julioflima/Blackout-Control/schematics/receiver-sch.pdf

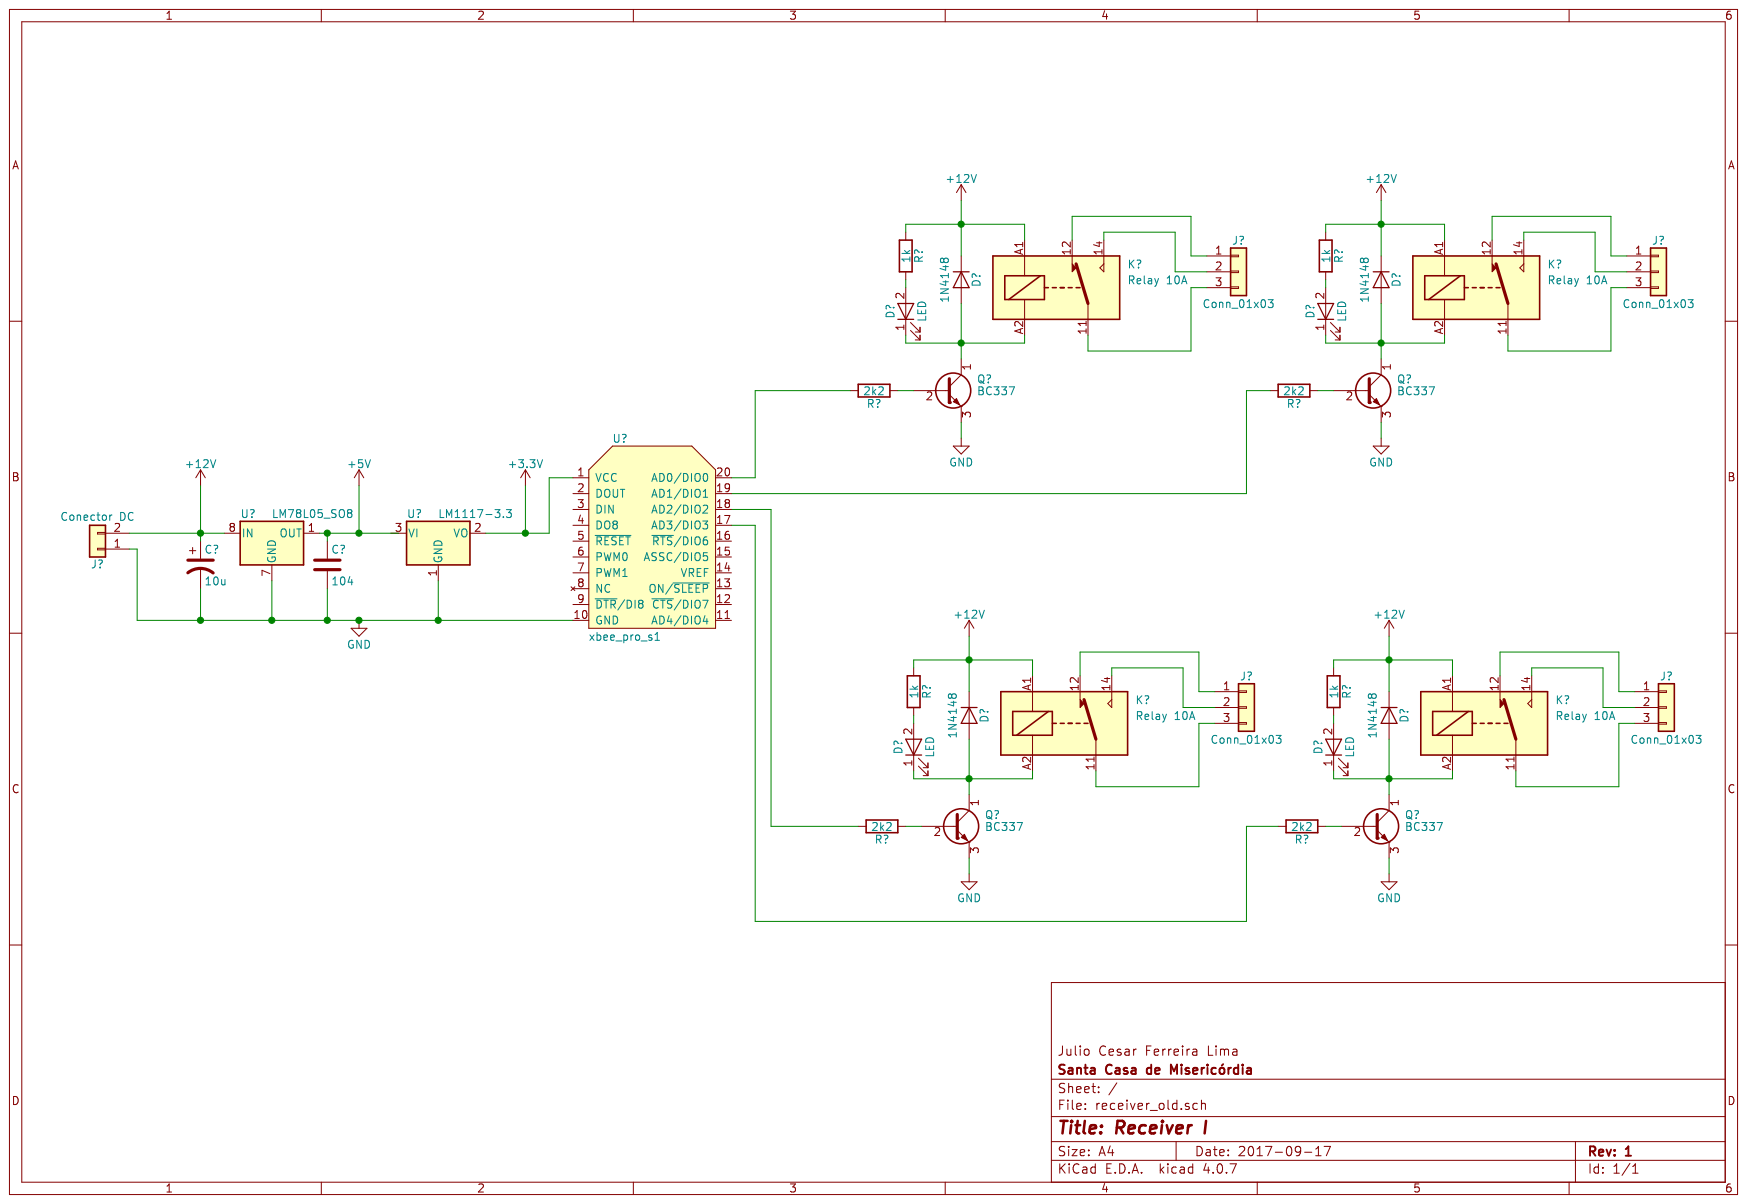
[picture p9: page 1]
