julioflima/Blackout-Control/schematics/transmitter-board.pdf

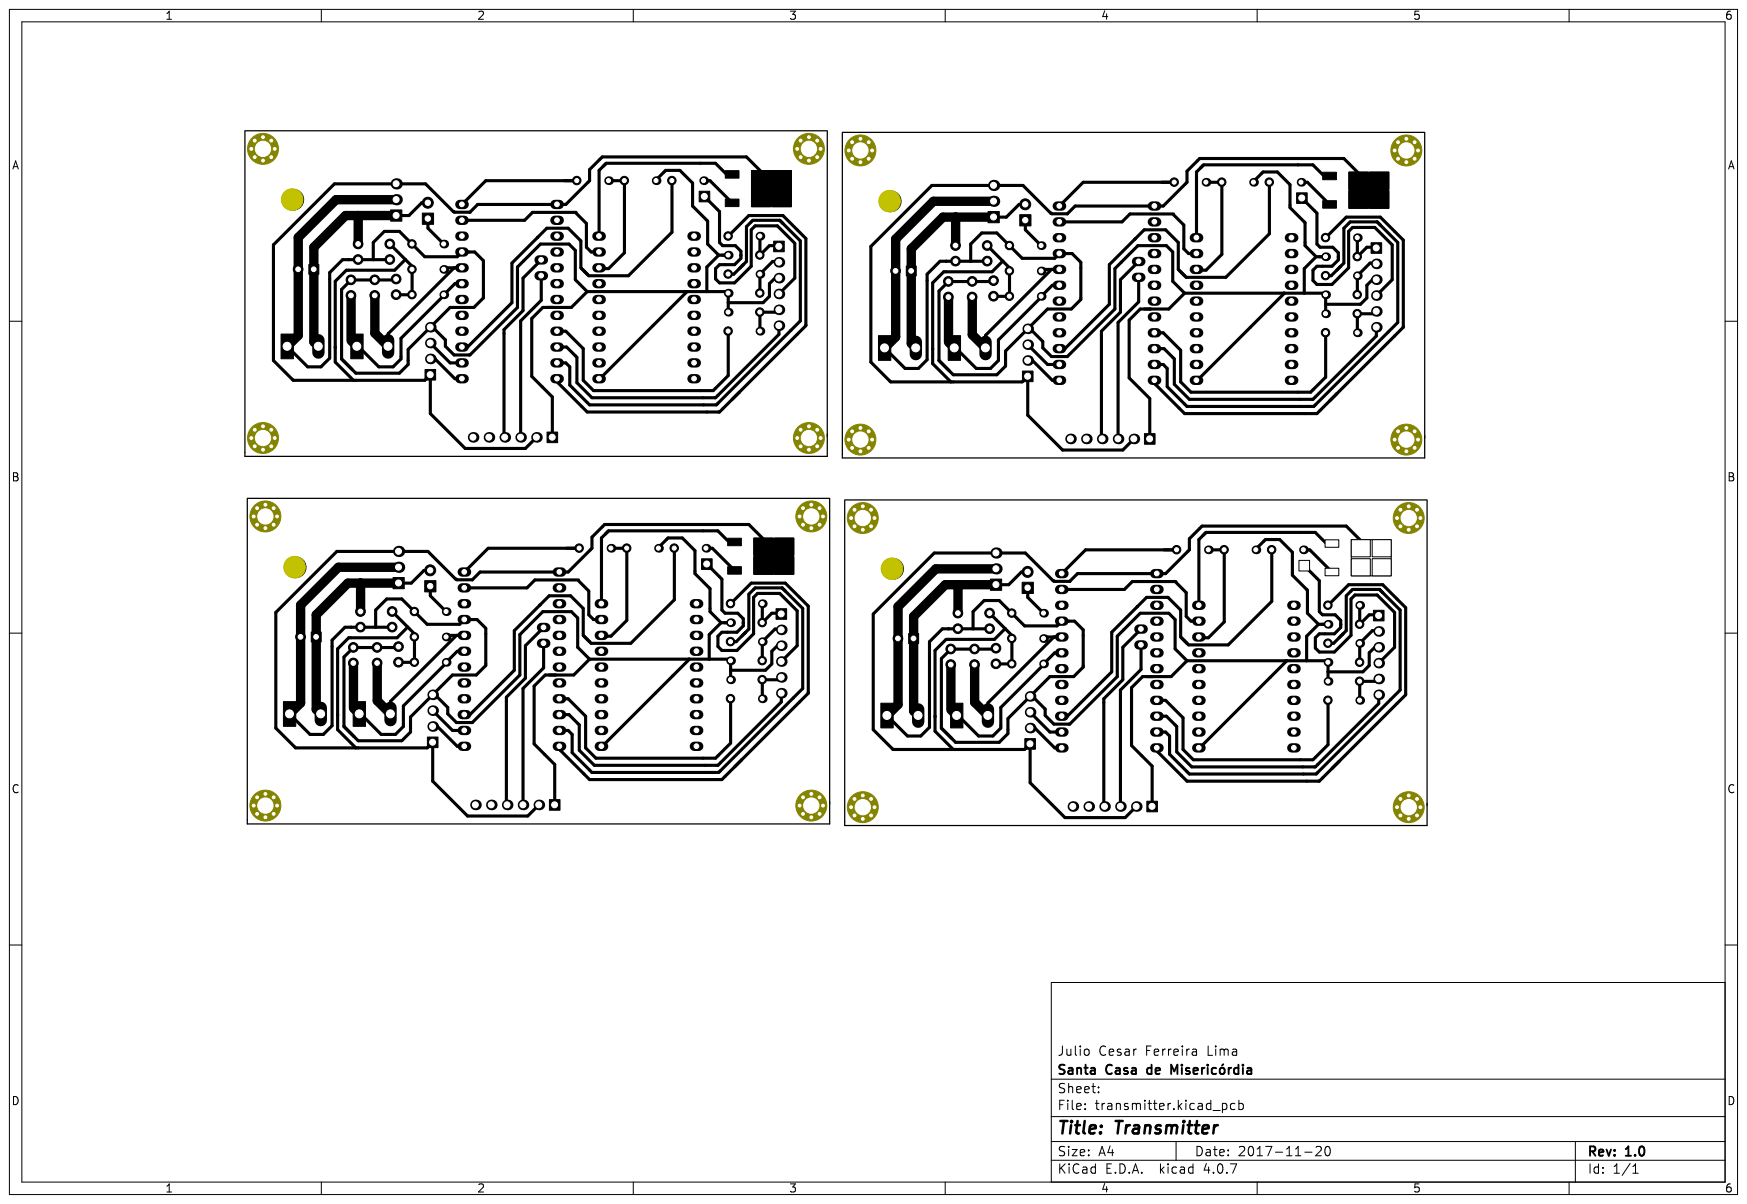
[picture p10: page 1]
