julioflima/Blackout-Control/schematics/transmitter-sch.pdf

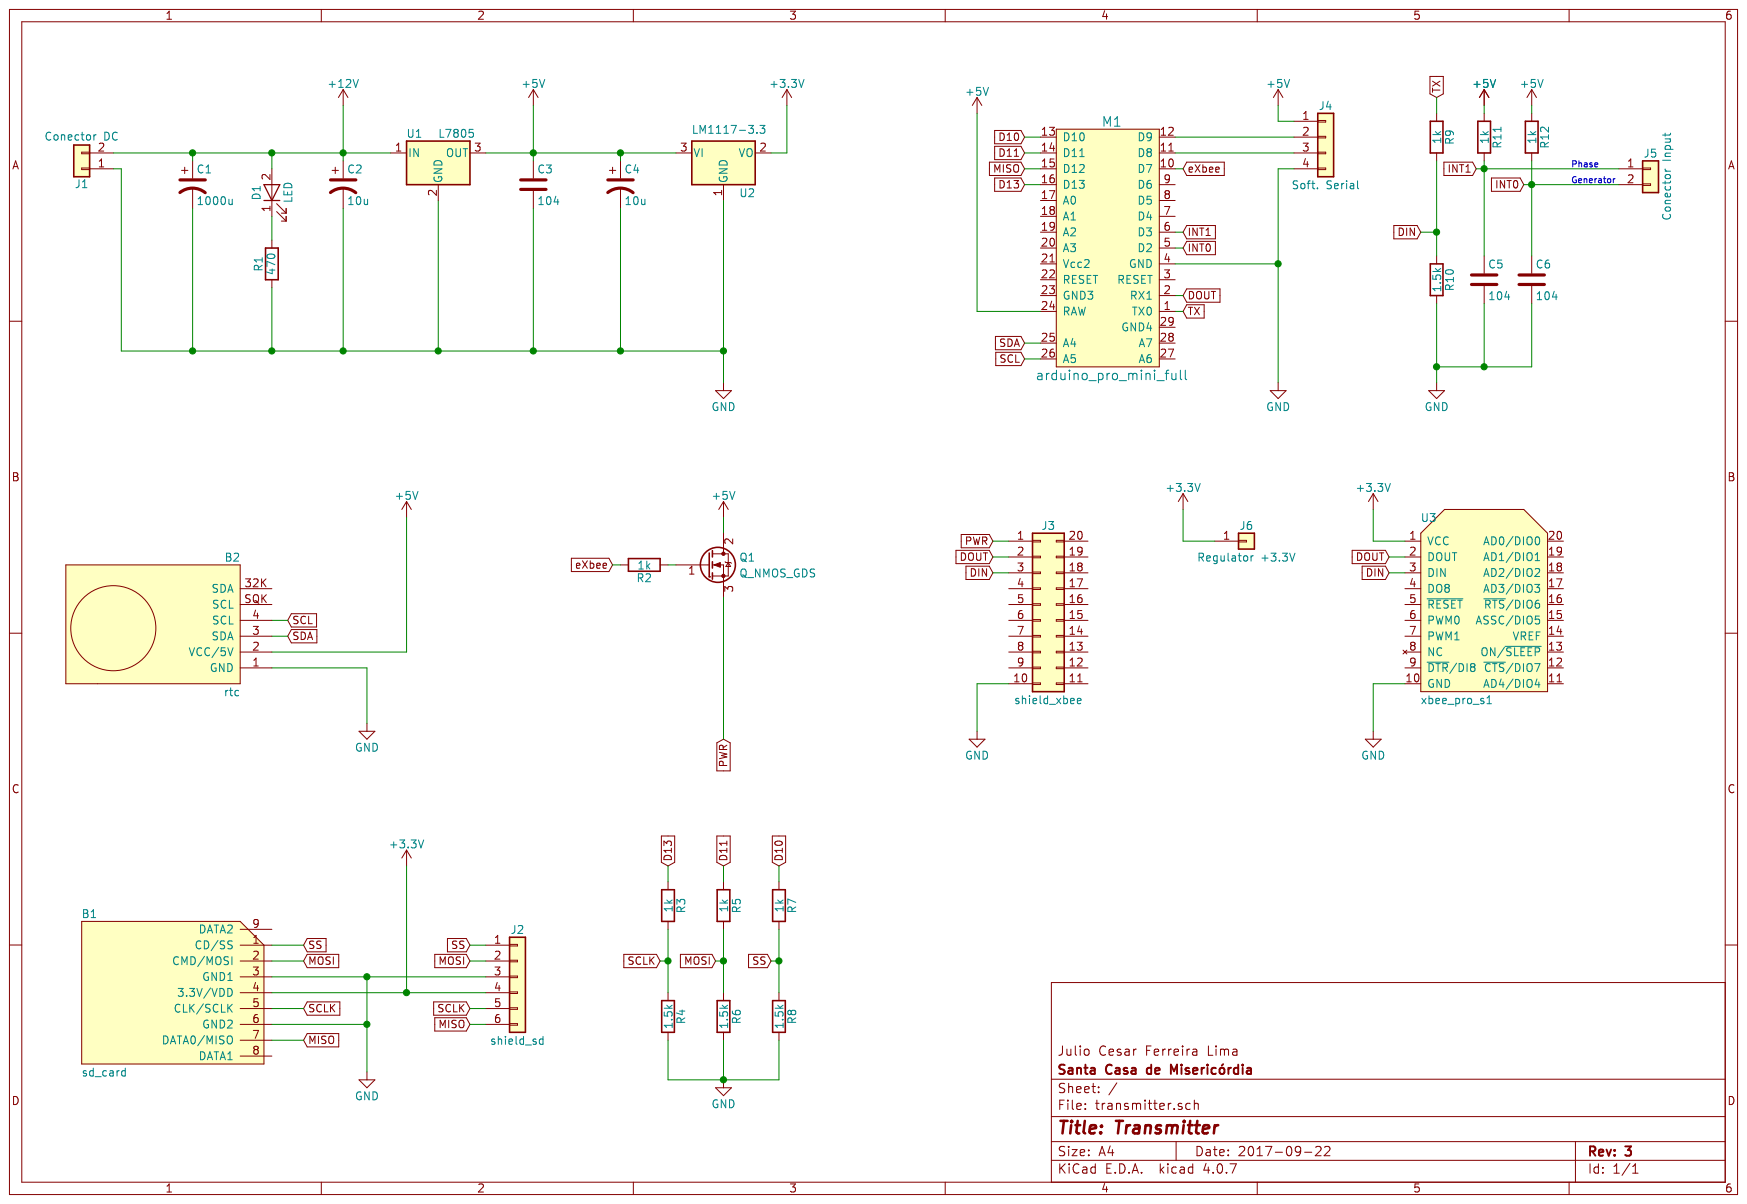
[picture p11: page 1]
