julioflima/Blackout-Control/(list of files, drawings)

Other design files:
kicad/Coordinator/transmitter.dsn
