julioflima/Blackout-Control/kicad/Coordinator/transmitter.sch

## KiCad design kicad/Coordinator/transmitter.sch (2017-12-10)

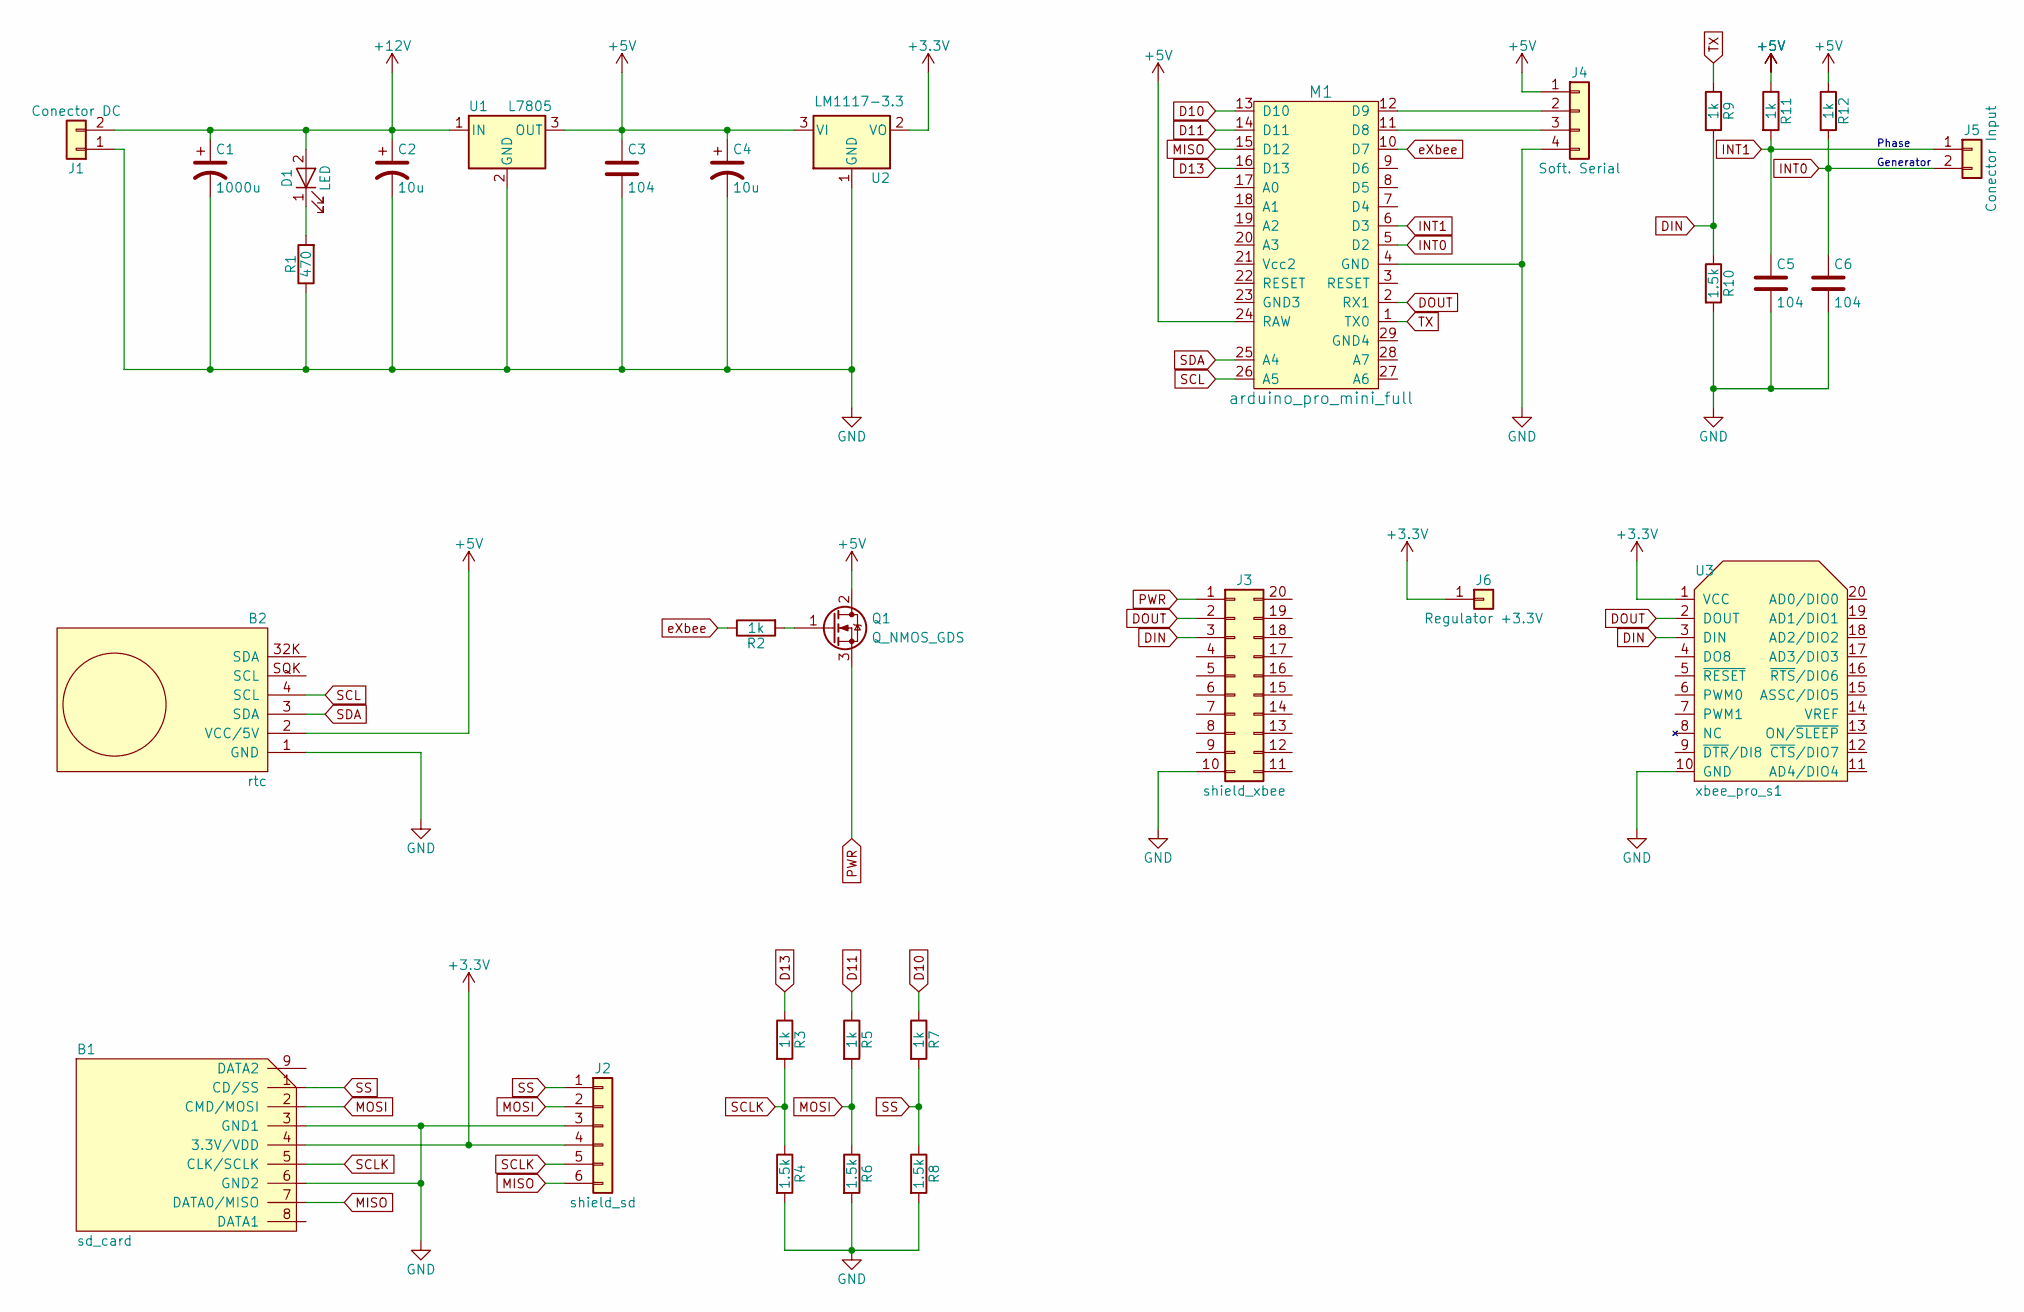
[picture p12: schematic transmitter.sch]

Parts:
B1: sd_card; SD CARD
B2: rtc; Pin_Header_Straight_1x06_Pitch2.54mm
C1: 1000u; C_Axial_L3.8mm_D2.6mm_P7.50mm_Horizontal
C2, C4: 10u; C_Axial_L3.8mm_D2.6mm_P7.50mm_Horizontal
C3, C5, C6: 104; C_Axial_L3.8mm_D2.6mm_P7.50mm_Horizontal
D1: LED; LED_D5.0mm
J1: Conector DC; TerminalBlock_Phoenix_MPT-2.54mm_2pol
J2: shield_sd; Pin_Header_Straight_1x06_Pitch2.54mm
J3: shield_xbee
J4: Soft. Serial; Pin_Header_Straight_1x04_Pitch2.54mm
J5: Conector Input; TerminalBlock_Phoenix_MPT-2.54mm_2pol
J6: Regulator +3.3V; Pin_Header_Straight_1x01_Pitch2.54mm
M1: arduino_pro_mini_full
Q1: Q_NMOS_GDS; TO-252-2
R1: 470; R_Axial_DIN0204_L3.6mm_D1.6mm_P5.08mm_Horizontal
R2, R3, R5, R7, R9, R11, R12: 1k; R_Axial_DIN0204_L3.6mm_D1.6mm_P5.08mm_Horizontal
R4, R6, R8, R10: 1.5k; R_Axial_DIN0204_L3.6mm_D1.6mm_P5.08mm_Horizontal
U1: L7805; TO-220-3_Horizontal
U2: LM1117-3.3
U3: xbee_pro_s1; XBEE

Connections:
+3.3V: B1.4 (3.3V/VDD), J2.4, J6.1, U2.2 (VO), U3.1 (VCC)
+5V: B2.2 (VCC/5V), C3.1, C4.1, J4.1, M1.24 (RAW), Q1.2 (D), R11.1, R12.1, U1.3 (OUT), U2.3 (VI)
+12V: C1.1, C2.1, D1.2 (A), J1.2, U1.1 (IN)
D10: M1.13 (D10), R7.1
D11: M1.14 (D11), R5.1
D13: M1.16 (D13), R3.1
DIN: J3.3, R9.2, R10.1, U3.3 (DIN)
DOUT: J3.2, M1.2 (RX1), U3.2 (DOUT)
GND: B1.3 (GND1), B1.6 (GND2), B2.1 (GND), C1.2, C2.2, C3.2, C4.2, C5.2, C6.2, J1.1, J2.3, J3.10, J4.4, M1.4 (GND), R1.1, R4.2, R6.2, R8.2, R10.2, U1.2 (GND), U2.1 (GND), U3.10 (GND)
INT0: C6.1, J5.2, M1.5 (D2), R12.2
INT1: C5.1, J5.1, M1.6 (D3), R11.2
MISO: B1.7 (DATA0/MISO), J2.6, M1.15 (D12)
MOSI: B1.2 (CMD/MOSI), J2.2, R5.2, R6.1
unnamed: D1.1 (K), R1.2
unnamed: J4.2, M1.12 (D9)
unnamed: J4.3, M1.11 (D8)
unnamed: Q1.1 (G), R2.2
PWR: J3.1, Q1.3 (S)
SCL: B2.4 (SCL), M1.26 (A5)
SCLK: B1.5 (CLK/SCLK), J2.5, R3.2, R4.1
SDA: B2.3 (SDA), M1.25 (A4)
SS: B1.1 (CD/SS), J2.1, R7.2, R8.1
TX: M1.1 (TX0), R9.1
eXbee: M1.10 (D7), R2.1

Notes on the sheet:
Phase
Generator
