julioflima/Blackout-Control/(commit log)

2017-10-29 Add to IDE
    -Added to Visua Micro in Visual Studio IDE.
    -Fixed "No File Directory" error.
    [Blackout-Control.cpp, Blackout-Control.h, Blackout-Control.ino]
2017-11-05 Database -Implemented: print, add, delete, Database. -Tested: print, add, delete, Database.
    *Implemented dbInit for test.
2017-11-06 Fix Major
    - Implemented: SoftwareSerial
    [Blackout-Control.cpp, Blackout-Control.h, BlackoutControl.ino]
2017-11-07 Watchog
    -Implement watchdog in reset().
    [Blackout-Control.cpp, Blackout-Control.h, BlackoutControl.ino]
2017-11-18 Extern Interruptions - CRASH
    [Blackout-Control.cpp, Blackout-Control.h, BlackoutControl.ino]
2017-11-18 Entern Interruptions - Init
